microchipthailand/dspic33ck-nano/arduino/dsPIC33CK_Nano_Pinout.html

# dsPIC33CK Nano — Arduino-compatible Pinout

dsPIC33CK256MC005 · 100 MIPS DSC · 256 KB flash · 16 KB RAM · USB-C power · breadboard 0.9″ rows · Arduino core dspicnano:dspic33ck:dspic33ck_nano

## Pinout (top view, USB-C at the top)

USB 5V after diode5V1

GND2

RP65PWM4HRD1 D353

RP42PWM3HRB10 D154

RP43PWM3LRB11 D165

RP44PWM2HRB12 D176

RP45PWM2LRB13 D187

RP46PWM1HRB14 D198

RP47PWM1LRB15 D209

RP60BUTTONRC12 D3310

RP61LED_BUILTINRC13 D3411

RESETMCLR12

RP77RD13 D3813

RP48AN12RC0A13D2114

CMP1AOA1OUTAN0RA0A0D015

OA1IN-AN16RA1A1D116

OA1IN+AN9RA2A2D217

CMP1CDACOUT1AN3RA3A3D318

OA3OUTAN4RA4A4D419

RP49CMP1BOA3IN-AN13RC1A14D2220

RP50CMP2BOA3IN+AN14RC2A15D2321

RP54AN19RC6A17D2722

dsPIC33CK Nano top view

13V33.3 V out, 250 mA

2GND

3D32 RC11Serial RXRP59

4D31 RC10Serial TXRP58

5D26 RC5MOSIRP53

6D25 RC4SCKRP52

7D14A12RB9AN11SDARP41

8D13A11RB8AN10SCLRP40

9D12A10RB7AN2RP39

10D11 RB6PGC3RP38

11D10 RB5PGD3RP37

12D36 RD8RP72

13D30 RC9SSRP57

14D29 RC8MISORP56

15D9A9RB4AN17OA2IN+RP36

16D8A8RB3AN8~PWMOA2IN-RP35

17D7A7RB2AN1~PWMOA2OUTCMP1DCMP2DRP34

18D28A18RC7AN7RP55

19D37A19RD10AN18RP74

20D6A6RB1AN6~PWMRP33

21D5A5RB0AN5~PWMRP32

22D24A16RC3AN15CMP2ARP51

D0Arduino digital pin

A0analogRead() name

RA0chip port pin (silkscreen)

AN0ADC channel

~PWManalogWrite()

SerialUART1

SDAWire

SCKSPI

LEDon-board

PGD3ICSP

PWM1Hother chip function

RP46remappable (PPS)

3V3power

GNDground

Left header is J2, right header is J3, both numbered from the USB-C end (pin 1 = 5V / 3V3). The rows are 0.9″ (22.86 mm) apart, so the board straddles a standard breadboard. The AN channel and the A name are different numbers on this chip — use the A name in sketches.

## Arduino functions

Function | Signal | Pin | Port | Header
Serial (UART1) | TX | D31 | RC10 | J3-4
Serial (UART1) | RX | D32 | RC11 | J3-3
Wire (I2C1) | SDA | D14 | RB9 | J3-7
Wire (I2C1) | SCL | D13 | RB8 | J3-8
SPI (SPI1) | SCK | D25 | RC4 | J3-6
SPI (SPI1) | MOSI | D26 | RC5 | J3-5
SPI (SPI1) | MISO | D29 | RC8 | J3-14
SPI (SPI1) | SS | D30 | RC9 | J3-13
analogWrite() | PWM1 | D5 | RB0 | J3-21
analogWrite() | PWM2 | D6 | RB1 | J3-20
analogWrite() | PWM3 | D7 | RB2 | J3-17
analogWrite() | PWM4 | D8 | RB3 | J3-16
On-board | LED_BUILTIN (active low) | D34 | RC13 | J2-11
On-board | BUTTON_BUILTIN (LOW = pressed) | D33 | RC12 | J2-10
ICSP J4 | PGD3 | D10 | RB5 | J3-11
ICSP J4 | PGC3 | D11 | RB6 | J3-10

## Analog inputs (analogRead, 12-bit → 0..1023)

Name | Pin | Port | ADC | Header
A0 | D0 | RA0 | AN0 | J2-15
A1 | D1 | RA1 | AN16 | J2-16
A2 | D2 | RA2 | AN9 | J2-17
A3 | D3 | RA3 | AN3 | J2-18
A4 | D4 | RA4 | AN4 | J2-19
A5 | D5 | RB0 | AN5 | J3-21
A6 | D6 | RB1 | AN6 | J3-20
A7 | D7 | RB2 | AN1 | J3-17
A8 | D8 | RB3 | AN8 | J3-16
A9 | D9 | RB4 | AN17 | J3-15
A10 | D12 | RB7 | AN2 | J3-9
A11 | D13 | RB8 | AN10 | J3-8
A12 | D14 | RB9 | AN11 | J3-7
A13 | D21 | RC0 | AN12 | J2-14
A14 | D22 | RC1 | AN13 | J2-20
A15 | D23 | RC2 | AN14 | J2-21
A16 | D24 | RC3 | AN15 | J3-22
A17 | D27 | RC6 | AN19 | J2-22
A18 | D28 | RC7 | AN7 | J3-18
A19 | D37 | RD10 | AN18 | J3-19

## On-board hardware

MCU | dsPIC33CK256MC005-I/PT, TQFP-48, internal FRC + PLL (no crystal)
Clock (Tools > Clock) | 100 MIPS (FOSC 200 MHz, default) or 4 MIPS (FRC 8 MHz)
Power | USB-C 5 V → B5819W diode → MCP1703A 3.3 V LDO, 250 mA
USER LED (D3, yellow) | RC13 = LED_BUILTIN = D34, active low — use LED_ON/LED_OFF
PWR LED (D2, green) | hard-wired to 3V3
USER button (SW2) | RC12 = BUTTON_BUILTIN = D33, 10 k pull-up on board, LOW = pressed
RESET button (SW1) | MCLR (10 k pull-up, 470 Ω + 100 nF)

J4 ICSP (6-pin) | 1 MCLR · 2 3V3 · 3 GND · 4 PGD3 (RB5) · 5 PGC3 (RB6) · 6 n/c — PICkit 4/5, SNAP
J5 UART (4-pin) | 1 3V3 · 2 TX (RC10) · 3 RX (RC11) · 4 GND — 3.3 V USB-serial adapter
PWM | D5 D6 D7 D8 (SCCP1-4, ~490 Hz)
Interrupts | attachInterrupt() on every pin (change notification)
Board size | 31.4 × 74.5 mm, 2 × 22 pins, red PCB

3.3 V only. The I/O pins are not 5 V tolerant. The 5V pin is USB power after the diode (about 4.6 V) — an output for modules, never a signal level.

- tone() borrows timer SCCP4, which is the PWM of D8. Don't use analogWrite(8, …) while a tone plays.
- RB5/RB6 (D10/D11) are the ICSP lines. They are free I/O when no debugger is connected, but anything wired there can disturb programming.
- RB10–RB15, RD1 are the motor-control PWM pins of the chip (PWM1H..PWM4H); in Arduino they are ordinary digital I/O.
- PORTA (RA0–RA4) has no PPS, so no remappable peripheral can use it; it is the best place for analog inputs.

## Getting started

1. Install XC-DSC v4.00+ (compiler) and MPLAB X (for uploading with a PICkit/SNAP).
2. In File > Preferences > Additional boards manager URLs add https://raw.githubusercontent.com/microchipthailand/dspic33ck-nano/main/package_dspicnano_index.json, then Tools > Board > Boards Manager → search dsPIC33CK Nano → Install. The device packs are installed automatically. Alternative for core development: copy arduino/hardware into your sketchbook so you get <sketchbook>/hardware/dspicnano/dspic33ck/boards.txt (do not use both at once).
3. Tools > Board → dsPIC33CK Nano (dsPIC33CK256MC005). Tools > Debugger → the programmer you have on J4.
4. Power the board from USB-C, plug the PICkit into J4 (pin 1 = MCLR, square pad), and upload File > Examples > dsPIC33CK_Nano > Lab01_Blink.

### Optional: upload over the J5 serial port (no PICkit)

1. Once, with the PICkit: Tools > Burn Bootloader.
2. Connect a 3.3 V USB-serial adapter to J5 (adapter RX → J5-2, adapter TX → J5-3, GND → J5-4), pick its COM port.
3. Tools > Bootloader → Serial over J5 (UART 115200), then Upload as usual.
4. If the sketch running on the board doesn't use Serial, the upload can't reset it. Hold USER, press and release RESET, keep holding USER for about a second (the LED stays on), then upload.

Uploading with the PICkit erases the bootloader. Burn it again before going back to serial uploads.

## Lab examples (File > Examples > dsPIC33CK_Nano)

# | Sketch | What it does | Learns | Extra parts

01 | Lab01_Blink | Blink the USER LED | digitalWrite, delay | nothing
02 | Lab02_ButtonLED | Button toggles LED, debounced | digitalRead, millis | nothing
03 | Lab03_SerialHello | Serial Monitor print + commands | Serial | USB-serial adapter on J5
04 | Lab04_AnalogRead | Potentiometer to volts | analogRead | 10k pot on A0 (J2-15)
05 | Lab05_PWMFade | PWM LED fade / pot dimmer | analogWrite, map | LED + 330R on D5 (J3-21)
06 | Lab06_Interrupt | Count presses in an ISR | attachInterrupt, volatile | nothing
07 | Lab07_Tone | Play a melody | tone, noTone, arrays | piezo on D9 (J3-15)
08 | Lab08_I2CScanner | Find I2C devices | Wire | any 3.3 V I2C module
09 | Lab09_SPILoopback | SPI self-test | SPI | jumper J3-5 to J3-14
10 | Lab10_DataLogger | 3-channel CSV logger + alarm | all of the above | pot, LDR, buzzer

## All digital pins

Pin | Port | Analog | ADC | Header | Functions
D0 | RA0 | A0 | AN0 | J2-15 | OA1OUT, CMP1A
D1 | RA1 | A1 | AN16 | J2-16 | OA1IN-
D2 | RA2 | A2 | AN9 | J2-17 | OA1IN+
D3 | RA3 | A3 | AN3 | J2-18 | DACOUT1, CMP1C
D4 | RA4 | A4 | AN4 | J2-19 | OA3OUT
D5 | RB0 | A5 | AN5 | J3-21 | ~PWM, RP32
D6 | RB1 | A6 | AN6 | J3-20 | ~PWM, RP33
D7 | RB2 | A7 | AN1 | J3-17 | ~PWM, OA2OUT, CMP1D, CMP2D, RP34
D8 | RB3 | A8 | AN8 | J3-16 | ~PWM, OA2IN-, RP35
D9 | RB4 | A9 | AN17 | J3-15 | OA2IN+, RP36
D10 | RB5 | | | J3-11 | PGD3, RP37
D11 | RB6 | | | J3-10 | PGC3, RP38
D12 | RB7 | A10 | AN2 | J3-9 | RP39
D13 | RB8 | A11 | AN10 | J3-8 | SCL, RP40
D14 | RB9 | A12 | AN11 | J3-7 | SDA, RP41
D15 | RB10 | | | J2-4 | PWM3H, RP42
D16 | RB11 | | | J2-5 | PWM3L, RP43
D17 | RB12 | | | J2-6 | PWM2H, RP44
D18 | RB13 | | | J2-7 | PWM2L, RP45
D19 | RB14 | | | J2-8 | PWM1H, RP46
D20 | RB15 | | | J2-9 | PWM1L, RP47
D21 | RC0 | A13 | AN12 | J2-14 | RP48
D22 | RC1 | A14 | AN13 | J2-20 | OA3IN-, CMP1B, RP49
D23 | RC2 | A15 | AN14 | J2-21 | OA3IN+, CMP2B, RP50
D24 | RC3 | A16 | AN15 | J3-22 | CMP2A, RP51
D25 | RC4 | | | J3-6 | SCK, RP52
D26 | RC5 | | | J3-5 | MOSI, RP53
D27 | RC6 | A17 | AN19 | J2-22 | RP54
D28 | RC7 | A18 | AN7 | J3-18 | RP55
D29 | RC8 | | | J3-14 | MISO, RP56
D30 | RC9 | | | J3-13 | SS, RP57
D31 | RC10 | | | J3-4 | Serial TX, RP58
D32 | RC11 | | | J3-3 | Serial RX, RP59
D33 | RC12 | | | J2-10 | BUTTON, RP60
D34 | RC13 | | | J2-11 | LED_BUILTIN, RP61
D35 | RD1 | | | J2-3 | PWM4H, RP65
D36 | RD8 | | | J3-12 | RP72
D37 | RD10 | A19 | AN18 | J3-19 | RP74
D38 | RD13 | | | J2-13 | RP77

Generated by tools/gen_pinout_html.py from variants/dspic33ck_nano/variant.c, pins_arduino.h and the PCB netlist (design.py). The script checks that the three agree before it writes this page.

Arduino-compatible core. Not affiliated with or endorsed by Arduino SA. “Arduino” is a trademark of Arduino SA. Microchip, dsPIC, MPLAB and Curiosity are trademarks of Microchip Technology Inc. See NOTICE.md.
