microchipthailand/dspic33ck-nano/pcb/kicad/tracks_bot.png

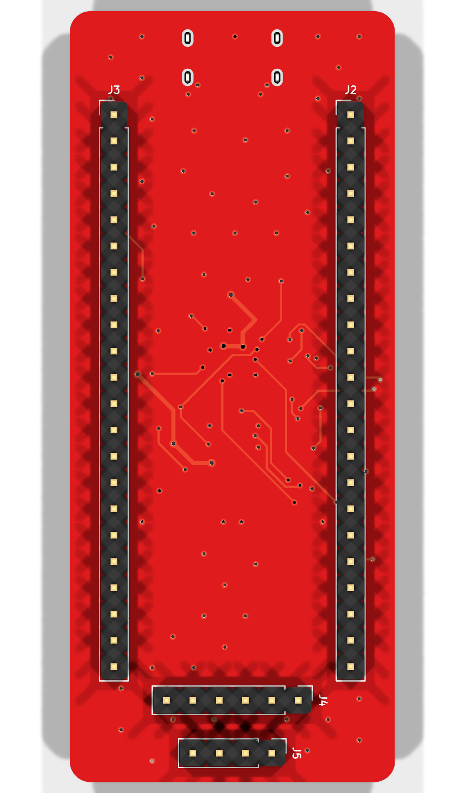
pcb/kicad/tracks_bot.png
