microchipthailand/dspic33ck-nano/pcb/kicad/tracks_top.png

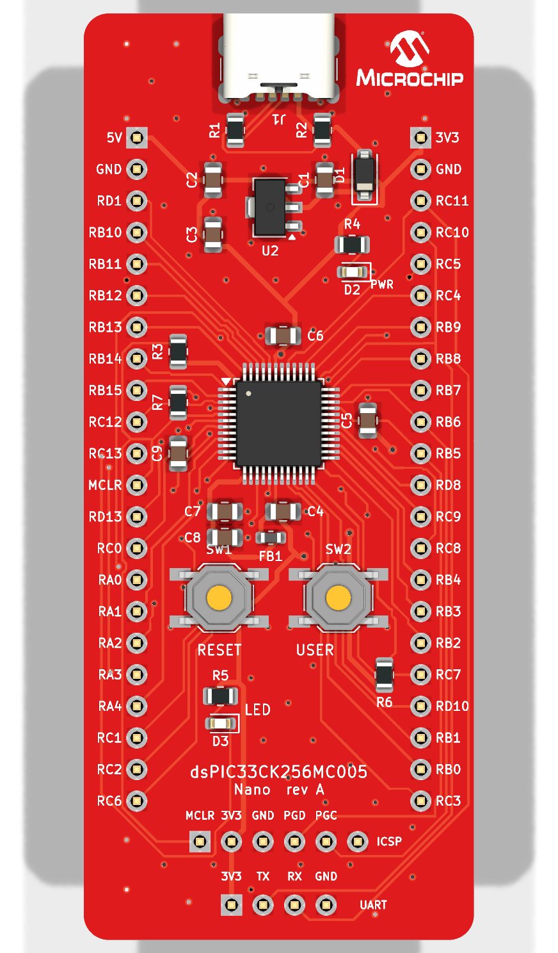
pcb/kicad/tracks_top.png
