microchipthailand/dspic33ck-nano/pcb/fabrication/assembly/dspic33ck_nano-bom.csv

Reference | Value | Footprint | QUANTITY | MPN
C1,C2,C8 | 1uF | Capacitor_SMD:C_0805_2012Metric | 3 | 0805 1uF 16V X7R
C3 | 10uF | Capacitor_SMD:C_0805_2012Metric | 1 | 0805 10uF 10V X5R
C4,C5,C6,C7,C9 | 100nF | Capacitor_SMD:C_0805_2012Metric | 5 | 0805 100nF 16V X7R
D1 | B5819W | Diode_SMD:D_SOD-123 | 1 | B5819W
D2 | PWR green | LED_SMD:LED_0603_1608Metric | 1 | 0603 green LED
D3 | USER yellow | LED_SMD:LED_0603_1608Metric | 1 | 0603 yellow LED
FB1 | 600R@100MHz | Inductor_SMD:L_0603_1608Metric | 1 | BLM18AG601SN1D
J1 | USB-C power | Connector_USB:USB_C_Receptacle_GCT_USB4125-xx-x-0190_6P_TopMnt_Horizontal | 1 | GCT USB4125-GF-A
J2 | LEFT | Connector_PinHeader_2.54mm:PinHeader_1x22_P2.54mm_Vertical | 1 | 1x22 2.54mm header
J3 | RIGHT | Connector_PinHeader_2.54mm:PinHeader_1x22_P2.54mm_Vertical | 1 | 1x22 2.54mm header
J4 | ICSP | Connector_PinHeader_2.54mm:PinHeader_1x06_P2.54mm_Vertical | 1 | 1x6 2.54mm header (PICkit)
J5 | UART | Connector_PinHeader_2.54mm:PinHeader_1x04_P2.54mm_Vertical | 1 | 1x4 2.54mm header (UART)
R1,R2 | 5.1k | Resistor_SMD:R_0805_2012Metric | 2 | 0805 5.1k 1%
R3,R6 | 10k | Resistor_SMD:R_0805_2012Metric | 2 | 0805 10k 1%
R4,R5 | 1k | Resistor_SMD:R_0805_2012Metric | 2 | 0805 1k 1%
R7 | 470 | Resistor_SMD:R_0805_2012Metric | 1 | 0805 470R 1%
SW1 | RESET | Button_Switch_SMD:SW_SPST_TL3342 | 1 | E-Switch TL3342 series (4.2x3.2mm SMD tact)
SW2 | USER | Button_Switch_SMD:SW_SPST_TL3342 | 1 | E-Switch TL3342 series (4.2x3.2mm SMD tact)
U1 | dsPIC33CK256MC005-I/PT | Package_QFP:TQFP-48_7x7mm_P0.5mm | 1 | dsPIC33CK256MC005-I/PT
U2 | MCP1703A-3302E/MB | Package_TO_SOT_SMD:SOT-89-3 | 1 | MCP1703AT-3302E/MB
