microchipthailand/dspic33ck-nano/pcb/kicad/board_guide.html

# dsPIC33CK256MC005 Nano Board

A breadboard-friendly development board for the Microchip dsPIC33CK256MC005 digital signal controller, powered from USB-C.

Rev A 31.4 × 74.5 mm 2 layers · 1.6 mm FR-4 Red mask · rounded corners USB-C 5 V → 3.3 V KiCad 10

## 1. Overview

This board breaks out every I/O pin of the dsPIC33CK256MC005-I/PT (48-pin TQFP, 7 × 7 mm, 0.5 mm pitch) to two 22-pin 2.54 mm headers. Its form factor follows Microchip's Curiosity Nano boards: a narrow stick that plugs straight into a solderless breadboard. It contains only what the MCU needs to run (power, decoupling, reset and programming), plus a UART header, two LEDs and two buttons.

### Key features

- dsPIC33CK256MC005: 100 MIPS, 256 KB flash, 24 KB RAM, motor-control PWM, 3 op-amps, 12-bit ADC
- USB-C power input (power only, no USB data)
- MCP1703A-3302 LDO: 3.3 V, 250 mA
- Ferrite-filtered analog supply (AVDD)
- 6-pin ICSP header for PICkit 4/5, MPLAB Snap or ICD
- 4-pin UART header (3V3 / TX / RX / GND)
- RESET and USER buttons, power and user LEDs
- All 0805 resistors and capacitors, easy to hand-solder

### Electrical summary

Input | 5 V via USB-C (or 5V header pin)
Logic level | 3.3 V. I/O pins are not 5 V tolerant unless the datasheet marks them so
3.3 V budget | 250 mA from the LDO, minus about 50–70 mA for the MCU at full speed
Clock | Internal FRC 8 MHz + PLL (no crystal fitted). RB0/RB1 are free for an external oscillator
Reverse-feed protection | B5819W Schottky between VBUS and the 5 V rail

## 2. Board views

3D render of the top side

Top side: components, pin labels and Microchip logo

3D render of the bottom side

Bottom side: pin headers point down into the breadboard (mirrored view)

Top copper routing

Top copper with the pours hidden: almost all signal routing is here

Bottom copper routing

Bottom copper with the pours hidden: only short crossings, so the GND plane stays almost unbroken

Header orientation. The pin headers mount on the bottom side with the pins pointing down, and the pin names are printed on the top side, so they can be read while the board is in a breadboard. Solder the headers from the top.

## 3. Block diagram

USB-C (J1) ──VBUS──► D1 B5819W ──+5V──► U2 MCP1703A-3302 ──+3V3──┬──► U1 VDD (pins 18, 32, 43) + 100 nF each │ CC1/CC2: 5.1 kΩ to GND (R1, R2) │ 1 µF 1 µF + 10 µF │ │ ▼ ├──► FB1 ferrite ──+3V3A──► U1 AVDD (pin 13) └─ 5V header pin (J2-1) ◄──────────── +5V rail │ 1 µF + 100 nF ├──► J3-1, ICSP J4-2, UART J5-1 └──► PWR LED D2 (via R4 1 kΩ) ┌──────────────────────── U1 dsPIC33CK256MC005-I/PT ────────────────────────┐ RESET ─► │ MCLR (5) ◄─ R3 10 kΩ pull-up ◄─ R7 470 Ω ◄─ C9 100 nF + SW1 │ ICSP J4 ─►│ PGD3/RB5 (33), PGC3/RB6 (34) │ UART J5 ◄►│ RC10/RP58 (40) = TX RC11/RP59 (41) = RX │ LED D3 ◄─│ RC13 (4), active low USER SW2 ─► RC12 (3), active low, R6 pull-up │ Headers ◄►│ all remaining I/O → J2 (left) / J3 (right) │ └────────────────────────────────────────────────────────────────────────────┘

## 4. Power supply

### USB-C input

J1 is a 6-pin power-only USB-C receptacle (GCT USB4125). R1/R2 (5.1 kΩ) pull CC1 and CC2 to ground, which tells the host or charger that this is a "sink" device. Without them, a USB-C charger supplies no power. The board asks for default USB power (500 mA from a USB 2.0 port, up to 1.5–3 A from a charger). It only needs a fraction of that.

### Reverse-feed protection

D1 (B5819W Schottky) sits between VBUS and the board's 5 V rail. The 5V header pin is on the protected side, so 5 V applied to that pin cannot flow back into a connected PC. The diode drops about 0.3–0.4 V, so the 5 V rail is about 4.6 V. That leaves plenty of headroom for the 3.3 V LDO.

### 3.3 V regulator

Part | MCP1703A-3302E/MB (SOT-89-3)
Pinout (SOT-89) | 1 = GND, 2 + tab = VIN, 3 = VOUT (from Microchip datasheet DS20005122, Table 3-1)
Input capacitor | C1 1 µF X7R
Output capacitors | C2 1 µF + C3 10 µF. The datasheet requires ≥ 1 µF and allows up to 22 µF ceramic. About 11 µF plus the 3×100 nF decoupling stays inside that range
Max output | 250 mA
Dissipation | (4.6 V − 3.3 V) × 100 mA ≈ 0.13 W, well within SOT-89 limits

### Analog supply

The MCU's AVDD (pin 13) powers the ADC, op-amps, comparators and DAC. It is fed through FB1, a 600 Ω at 100 MHz ferrite bead, and decoupled with C7 100 nF + C8 1 µF, which keeps digital switching noise out of analog measurements. AVSS (pin 14) goes straight to the ground plane.

Powering from the headers: you can power the board from 5 V on J2-1 (5V), or from 3.3 V on J3-1 (3V3), which bypasses the LDO. Never feed 3.3 V into the 3V3 pin while USB-C is also connected. The UART header's 3V3 pin is the same rail, so connect it only if the USB-serial adapter is meant to power the board.

## 5. MCU support circuitry

Function | Parts | Notes
VDD decoupling | C4 (pin 18), C5 (pin 32), C6 (pin 43): 100 nF | One per VDD pin, each placed right at its pin, with its own GND via to the bottom plane
VCAP | none | The dsPIC33CK family has no VCAP pin, so no core-regulator capacitor is needed
Reset (MCLR, pin 5) | R3 10 kΩ pull-up, R7 470 Ω, C9 100 nF, SW1 | R7 isolates C9 and SW1 from the pin, so the programmer can still drive the VPP/MCLR edge cleanly (Microchip's recommended circuit)
Clock | none fitted | Internal FRC + PLL gives the full 100 MIPS. For a crystal, use OSCI/RB0 (pin 21) and OSCO/RB1 (pin 22) from the headers

## 6. Header pinout

The pins are numbered from the USB-C end. The left header is J2 and the right header is J3 (as seen from the top). The rows are 0.9" (22.86 mm) apart. The order follows the chip's pins around the package, which keeps the traces short and untangled.

Pin | J2 (left) | MCU pin | Main functions
1 | 5V | — | 5 V rail (after D1)
2 | GND | — | Ground
3 | RD1 | 44 | RP65 · PWM4H · RD1
4 | RB10 | 45 | TMS · RP42 · PWM3H · RB10
5 | RB11 | 46 | TCK · RP43 · PWM3L · RB11
6 | RB12 | 47 | TDI · RP44 · PWM2H · RB12
7 | RB13 | 48 | RP45 · PWM2L · RB13
8 | RB14 | 1 | RP46 · PWM1H · RB14
9 | RB15 | 2 | RP47 · PWM1L · RB15
10 | RC12 | 3 | RP60 · RC12 — USER button
11 | RC13 | 4 | RP61 · RC13 — USER LED
12 | MCLR | 5 | MCLR — Reset / ICSP VPP
13 | RD13 | 6 | ANN0 · RP77 · RD13
14 | RC0 | 7 | AN12 · RP48 · RC0
15 | RA0 | 8 | OA1OUT · AN0 · CMP1A · IBIAS0 · RA0
16 | RA1 | 9 | OA1IN- · AN16 · RA1
17 | RA2 | 10 | OA1IN+ · AN9 · RA2
18 | RA3 | 11 | DACOUT1 · AN3 · CMP1C · RA3
19 | RA4 | 12 | OA3OUT · AN4 · IBIAS3 · RA4
20 | RC1 | 15 | OA3IN- · AN13 · CMP1B · ISRC0 · RP49 · RC1
21 | RC2 | 16 | OA3IN+ · AN14 · CMP2B · ISRC1 · RP50 · RC2
22 | RC6 | 17 | AN19 · IBIAS1 · RP54 · RC6

Pin | J3 (right) | MCU pin | Main functions
1 | 3V3 | — | 3.3 V rail (LDO output)
2 | GND | — | Ground
3 | RC11 | 41 | RP59 · RC11 — UART RX (J5-3)
4 | RC10 | 40 | RP58 · RC10 — UART TX (J5-2)
5 | RC5 | 39 | RP53 · RC5
6 | RC4 | 38 | RP52 · RC4
7 | RB9 | 37 | PGC1 · AN11 · RP41 · SDA1 · RB9
8 | RB8 | 36 | PGD1 · AN10 · RP40 · SCL1 · RB8
9 | RB7 | 35 | TDO · AN2 · RP39 · RB7
10 | RB6 | 34 | PGC3 · RP38 · RB6 — ICSP PGC
11 | RB5 | 33 | PGD3 · RP37 · RB5 — ICSP PGD
12 | RD8 | 30 | RP72 · SDO2 · PCI19 · RD8
13 | RC9 | 29 | RP57 · ASCL1 · SDI2 · RC9
14 | RC8 | 28 | RP56 · ASDA1 · SCK2 · RC8
15 | RB4 | 27 | PGC2 · OA2IN+ · AN17 · RP36 · RB4
16 | RB3 | 26 | PGD2 · OA2IN- · AN8 · RP35 · RB3
17 | RB2 | 25 | OA2OUT · AN1 · CMP1D · CMP2D · RP34 · INT0 · RB2
18 | RC7 | 24 | AN7 · ISRC2 · RP55 · RC7
19 | RD10 | 23 | AN18 · ISRC3 · RP74 · RD10
20 | RB1 | 22 | OSCO · CLKO · AN6 · RP33 · RB1
21 | RB0 | 21 | OSCI · CLKI · AN5 · RP32 · RB0
22 | RC3 | 20 | AN15 · CMP2A · IBIAS2 · RP51 · RC3

PWR power GND ground PROG used by on-board circuitry or programming I/O general-purpose

Pins marked PROG are shared with on-board functions. RB5/RB6 are the programming pins (PGD3/PGC3), RC10/RC11 the UART, RC12 the USER button (10 kΩ pull-up) and RC13 the USER LED. You can still use them from the header, but take the on-board load into account.

### Useful peripheral pins

Peripheral | Pins
Motor-control PWM | PWM1H/L = RB14/RB15 · PWM2H/L = RB12/RB13 · PWM3H/L = RB10/RB11 · PWM4H = RD1
Op-amp 1 (current sense) | OA1OUT = RA0 · OA1IN− = RA1 · OA1IN+ = RA2
Op-amp 2 | OA2OUT = RB2 · OA2IN− = RB3 · OA2IN+ = RB4
Op-amp 3 | OA3OUT = RA4 · OA3IN− = RC1 · OA3IN+ = RC2
DAC output | DACOUT1 = RA3
I²C1 (fixed) | SCL1 = RB8 · SDA1 = RB9 (alternate ASCL1/ASDA1 = RC9/RC8)
SPI2 (fixed) | SCK2 = RC8 · SDI2 = RC9 · SDO2 = RD8
Remappable (PPS) | Every RPxx pin can carry UART, SPI1, QEI, SENT, timers, input capture and similar peripherals

## 7. Programming and debugging (J4, ICSP)

J4 is a 6-pin 2.54 mm header in Microchip's standard ICSP order. Pin 1 is marked with a square pad and the MCLR label.

Pin | Signal | Connects to
1 | MCLR / VPP | U1 pin 5
2 | VDD (3.3 V) | +3V3 rail (the programmer senses the target voltage)
3 | GND | Ground
4 | PGD | PGD3 / RB5, U1 pin 33
5 | PGC | PGC3 / RB6, U1 pin 34
6 | — | Not connected (LVP/aux on PICkit)

PGD3/PGC3 were chosen because the other two programming pairs share pins with useful peripherals: PGx1 = RB8/RB9 carries I²C1, and PGx2 = RB3/RB4 carries op-amp 2's inputs. Your firmware must select PGx3 in its configuration bits (see the firmware section). Otherwise debugging won't connect.

Power the board from USB-C while programming. A PICkit can also power the target from pin 2, but don't do both at once.

## 8. UART header (J5)

Pin | Signal | MCU | Connect to USB-serial adapter
1 | 3V3 | +3V3 rail | VCC, only if the adapter should power the board and USB-C is unplugged
2 | TX (board output) | RC10 / RP58 (pin 40) | adapter RX
3 | RX (board input) | RC11 / RP59 (pin 41) | adapter TX
4 | GND | Ground | GND (always)

Use a 3.3 V adapter (FTDI TTL-232R-3V3, CP2102 or CH340 set to 3.3 V, MCP2221A). A 5 V adapter can damage the RX pin. UART1 is routed to these pins with peripheral pin select (PPS) in firmware; see below.

## 9. LEDs and buttons

Ref | Function | Connection | Logic
D2 (green) | Power LED | +3V3 → R4 1 kΩ → LED → GND | On whenever 3.3 V is present (about 1.3 mA)
D3 (yellow) | User LED | +3V3 → R5 1 kΩ → LED → RC13 | Active low: drive RC13 = 0 to light it
SW1 | RESET | MCLR via R7/C9 | Press to reset
SW2 | USER | RC12 → GND, R6 10 kΩ pull-up | Active low: reads 0 when pressed

## 10. Firmware starter (MPLAB X + XC-DSC/XC16)

A minimal program for this board: 100 MIPS from the internal oscillator, UART1 on J5 at 115200 baud, and the user LED following the button.

#include <xc.h>

// ---- configuration bits ----
#pragma config FNOSC = FRC          // start on FRC, switch to PLL in code
#pragma config FCKSM = CSECMD       // clock switching enabled
#pragma config ICS   = PGD3         // debugger on PGC3/PGD3 (J4) -- required!
#pragma config JTAGEN = OFF
#pragma config FWDTEN = ON_SW       // watchdog under software control

#define FCY 100000000UL             // 100 MIPS

static void clock_init(void)
{
    // FRC 8 MHz: FPLLO = 8 MHz * M / (N1 * N2 * N3) = 8 * 150 / (1 * 3 * 1) = 400 MHz; FCY = FPLLO/4 = 100 MHz
    CLKDIVbits.PLLPRE = 1;
    PLLFBDbits.PLLFBDIV = 150;
    PLLDIVbits.POST1DIV = 3;
    PLLDIVbits.POST2DIV = 1;
    __builtin_write_OSCCONH(0x01);  // new oscillator: FRC + PLL
    __builtin_write_OSCCONL(OSCCON | 0x01);
    while (OSCCONbits.OSWEN);       // wait for switch
    while (!OSCCONbits.LOCK);       // wait for PLL lock
}

static void pins_init(void)
{
    __builtin_write_RPCON(0x0000);  // unlock PPS
    _RP58R = 1;                     // RC10/RP58 -> U1TX   (J5 pin 2)
    _U1RXR = 59;                    // U1RX <- RC11/RP59    (J5 pin 3)
    __builtin_write_RPCON(0x0800);  // lock PPS

    _TRISC10 = 0;  _TRISC11 = 1;  _CNPUC11 = 1;   // UART: TX out, RX in with pull-up
    _TRISC13 = 0;  _LATC13 = 1;                   // user LED off (active low)
    _TRISC12 = 1;                                 // user button input (external pull-up)
}

static void uart1_init(unsigned long baud)
{
    U1MODEbits.BRGH = 0;                          // standard (16x) baud mode
    U1BRG = (FCY / (16UL * baud)) - 1;            // assumes UART clock = FCY (default); see note below
    U1MODEbits.UTXEN = 1;
    U1MODEbits.URXEN = 1;
    U1MODEbits.UARTEN = 1;
}

static void uart1_putc(char c) { while (U1STAHbits.UTXBF); U1TXREG = c; }
static void uart1_puts(const char *s) { while (*s) uart1_putc(*s++); }

int main(void)
{
    clock_init();
    pins_init();
    uart1_init(115200);
    uart1_puts("dsPIC33CK Nano ready\r\n");

    while (1) {
        _LATC13 = _RC12;            // LED on while USER button pressed (both active low)
    }
}

Check these against the dsPIC33CK256MC506 family datasheet before relying on them. The register and bit names (_RP58R, _U1RXR, _TRISC10, _CNPUC11, RPINR18/RPOR13) were confirmed in the device header p33CK256MC005.h from the installed device pack. The rest are written from memory and need checking:

- the PPS output code (U1TX = 1)
- the __builtin_write_RPCON unlock/lock values
- whether RC10/RC11 need ANSEL turned off
- the PLL divider values
- the UART baud formula, which depends on the UART clock source (U1MODEH.BCLKSEL)

Alternatively, use MCC (MPLAB Code Configurator), which generates verified setup code for the clock, PPS and UART.

## 11. PCB design

Item | Value
Size | 31.4 × 74.5 mm (header rows 0.9" apart, with a 3 mm label strip outside each row)
Board outline | Rectangle with 2.0 mm radius rounded corners (all four)
Stack-up | 2 layers, 1.6 mm FR-4, 1 oz copper
Finish | Red solder mask (both sides), white silkscreen, HASL lead-free
Logo | Microchip logo on top silkscreen, right of the USB-C connector (about 8.6 × 4.5 mm)
Top layer (F.Cu) | All components and most signal routing (about 89% of track length), plus a GND pour
Bottom layer (B.Cu) | Solid GND plane with only short signal crossings; pin headers are mounted on this side
Signal tracks | 0.20 mm width, 0.20 mm clearance
Power tracks (VBUS, +5V, +3V3, +3V3A, GND) | 0.40 mm width, 0.15 mm clearance
Vias | 0.6 mm / 0.3 mm drill (signal), 0.8 mm / 0.4 mm drill (power)
Copper to board edge | 0.30 mm
Fabrication class | Within JLCPCB / PCBWay standard 2-layer capability (no extra-cost options)

### Grounding approach

- Every GND pad has its own short trace and via to the bottom plane. That includes all four MCU ground pins (14, 19, 31, 42), whose vias sit under the chip body.
- The router was set to make bottom-layer traces 8× more costly than top-layer ones, so the plane stays almost unbroken under the MCU.
- Stitching vias tie the top-side GND pour to the bottom plane across the whole board, and pour fragments that don't reach a GND pad are removed.
- A connectivity check confirmed that all 135 GND items (pads, tracks, vias and pour pieces) form one single connected net.

### Verification results

Schematic ERC: 0 errors, 0 warnings.
Netlist check: 156 of 156 pins match the design specification.
PCB DRC: 0 errors, 0 unconnected items, with KiCad's schematic-parity check on. The only remaining note is ICSP J4 pin 6, which is unconnected on purpose.
GND connectivity: a single connected group across both layers.

## 12. Bill of materials

Ref | Qty | Value | Package | Description / part
C1,C2,C8 | 3 | 1uF | C_0805 (2012 metric) | 0805 1uF 16V X7R
C3 | 1 | 10uF | C_0805 (2012 metric) | 0805 10uF 10V X5R
C4-C7,C9 | 5 | 100nF | C_0805 (2012 metric) | 0805 100nF 16V X7R
D1 | 1 | B5819W | D_SOD-123 | B5819W
D2 | 1 | PWR green | LED_0603 (1608 metric) | 0603 green LED
D3 | 1 | USER yellow | LED_0603 (1608 metric) | 0603 yellow LED
FB1 | 1 | 600R@100MHz | L_0603 (1608 metric) | BLM18AG601SN1D
J1 | 1 | USB-C power | USB-C 6P horizontal | GCT USB4125-GF-A
J2 | 1 | LEFT | Header 1x22 2.54 mm | 1x22 2.54mm header
J3 | 1 | RIGHT | Header 1x22 2.54 mm | 1x22 2.54mm header
J4 | 1 | ICSP | Header 1x06 2.54 mm | 1x6 2.54mm header (PICkit)
J5 | 1 | UART | Header 1x04 2.54 mm | 1x4 2.54mm header (UART)
R1,R2 | 2 | 5.1k | R_0805 (2012 metric) | 0805 5.1k 1%
R3,R6 | 2 | 10k | R_0805 (2012 metric) | 0805 10k 1%
R4,R5 | 2 | 1k | R_0805 (2012 metric) | 0805 1k 1%
R7 | 1 | 470 | R_0805 (2012 metric) | 0805 470R 1%
SW1 | 1 | RESET | SW_SPST_TL3342 | E-Switch TL3342 series (4.2x3.2mm SMD tact)
SW2 | 1 | USER | SW_SPST_TL3342 | E-Switch TL3342 series (4.2x3.2mm SMD tact)
U1 | 1 | dsPIC33CK256MC005-I/PT | TQFP-48_7x7mm_P0.5mm | dsPIC33CK256MC005-I/PT
U2 | 1 | MCP1703A-3302E/MB | SOT-89-3 | MCP1703AT-3302E/MB

Several entries in the "part" column are generic descriptions, such as "0805 100nF 16V X7R". Choose a specific manufacturer part (for example from JLCPCB's basic parts library) before ordering assembly. For the LEDs, check the cathode mark: KiCad pin 1 = K (cathode).

## 13. Assembly notes

1. Order of soldering: start with U1 (TQFP-48), then U2, the USB-C connector J1, the passives, the LEDs and the buttons. Fit the pin headers last.
2. TQFP-48: tack two opposite corner pins, check the alignment on all four sides, then drag-solder with plenty of flux and clear bridges with wick. Pin 1 is marked by the triangle on the silkscreen.
3. LED polarity: the cathode goes to the pad marked on the silkscreen. D2's cathode goes to GND; D3's cathode goes to RC13.
4. D1 polarity: the cathode band faces the LDO (+5V side).
5. Pin headers: insert them from the bottom with the long pins pointing down, and solder from the top. To keep them straight, push the headers into a breadboard first, lay the board on top and then solder.
6. Clean the flux off, especially around the TQFP and MCLR network. Leftover flux can leak current on high-impedance nodes.

## 14. Bring-up checklist

1. Before applying power: check for shorts with a meter. 5V to GND, 3V3 to GND and 3V3A to GND should each read high resistance, not 0 Ω.
2. Plug in USB-C: the green PWR LED should light up. Measure the 3V3 pin: 3.25–3.35 V. Measure the 5V pin: about 4.6 V.
3. Measure AVDD at C8: it should equal 3V3.
4. Measure MCLR (J4-1): it should be at 3.3 V, and drop to 0 V while RESET is held.
5. Connect a PICkit to J4 (pin 1 = MCLR). In MPLAB X, choose Read Device ID; it should identify the dsPIC33CK256MC005.
6. Program the starter firmware. Open a terminal at 115200 8N1 on the UART adapter and look for "dsPIC33CK Nano ready". Press USER and the yellow LED should light.

## 15. Project files

File | Contents
dspic33ck_nano.kicad_pro | KiCad project (open this). Contains the design rules and net classes
dspic33ck_nano.kicad_sch | Schematic
dspic33ck_nano.kicad_pcb | Routed PCB
Board.kicad_sym | Project symbols: the dsPIC33CK256MC005 (pinout from Microchip's device file) and the MCP1703A in SOT-89
schematic.pdf · bom.csv | Exports
pcb/scripts/ | Generators: design.py (parts and nets) and build.sh, plus the routing scripts

Generated 2026-11-11 · dsPIC33CK256MC005 Nano board Rev A · KiCad 10.0.7 · routed with Freerouting 2.5.0.
The MCU pinout comes from Microchip's DSPIC33CK256MC005.PIC device file (dsPIC33CK-MC_DFP 1.10.386); the regulator data from MCP1703A datasheet DS20005122.
