microchipthailand/dspic33ck-nano/pcb/kicad/schematic.pdf

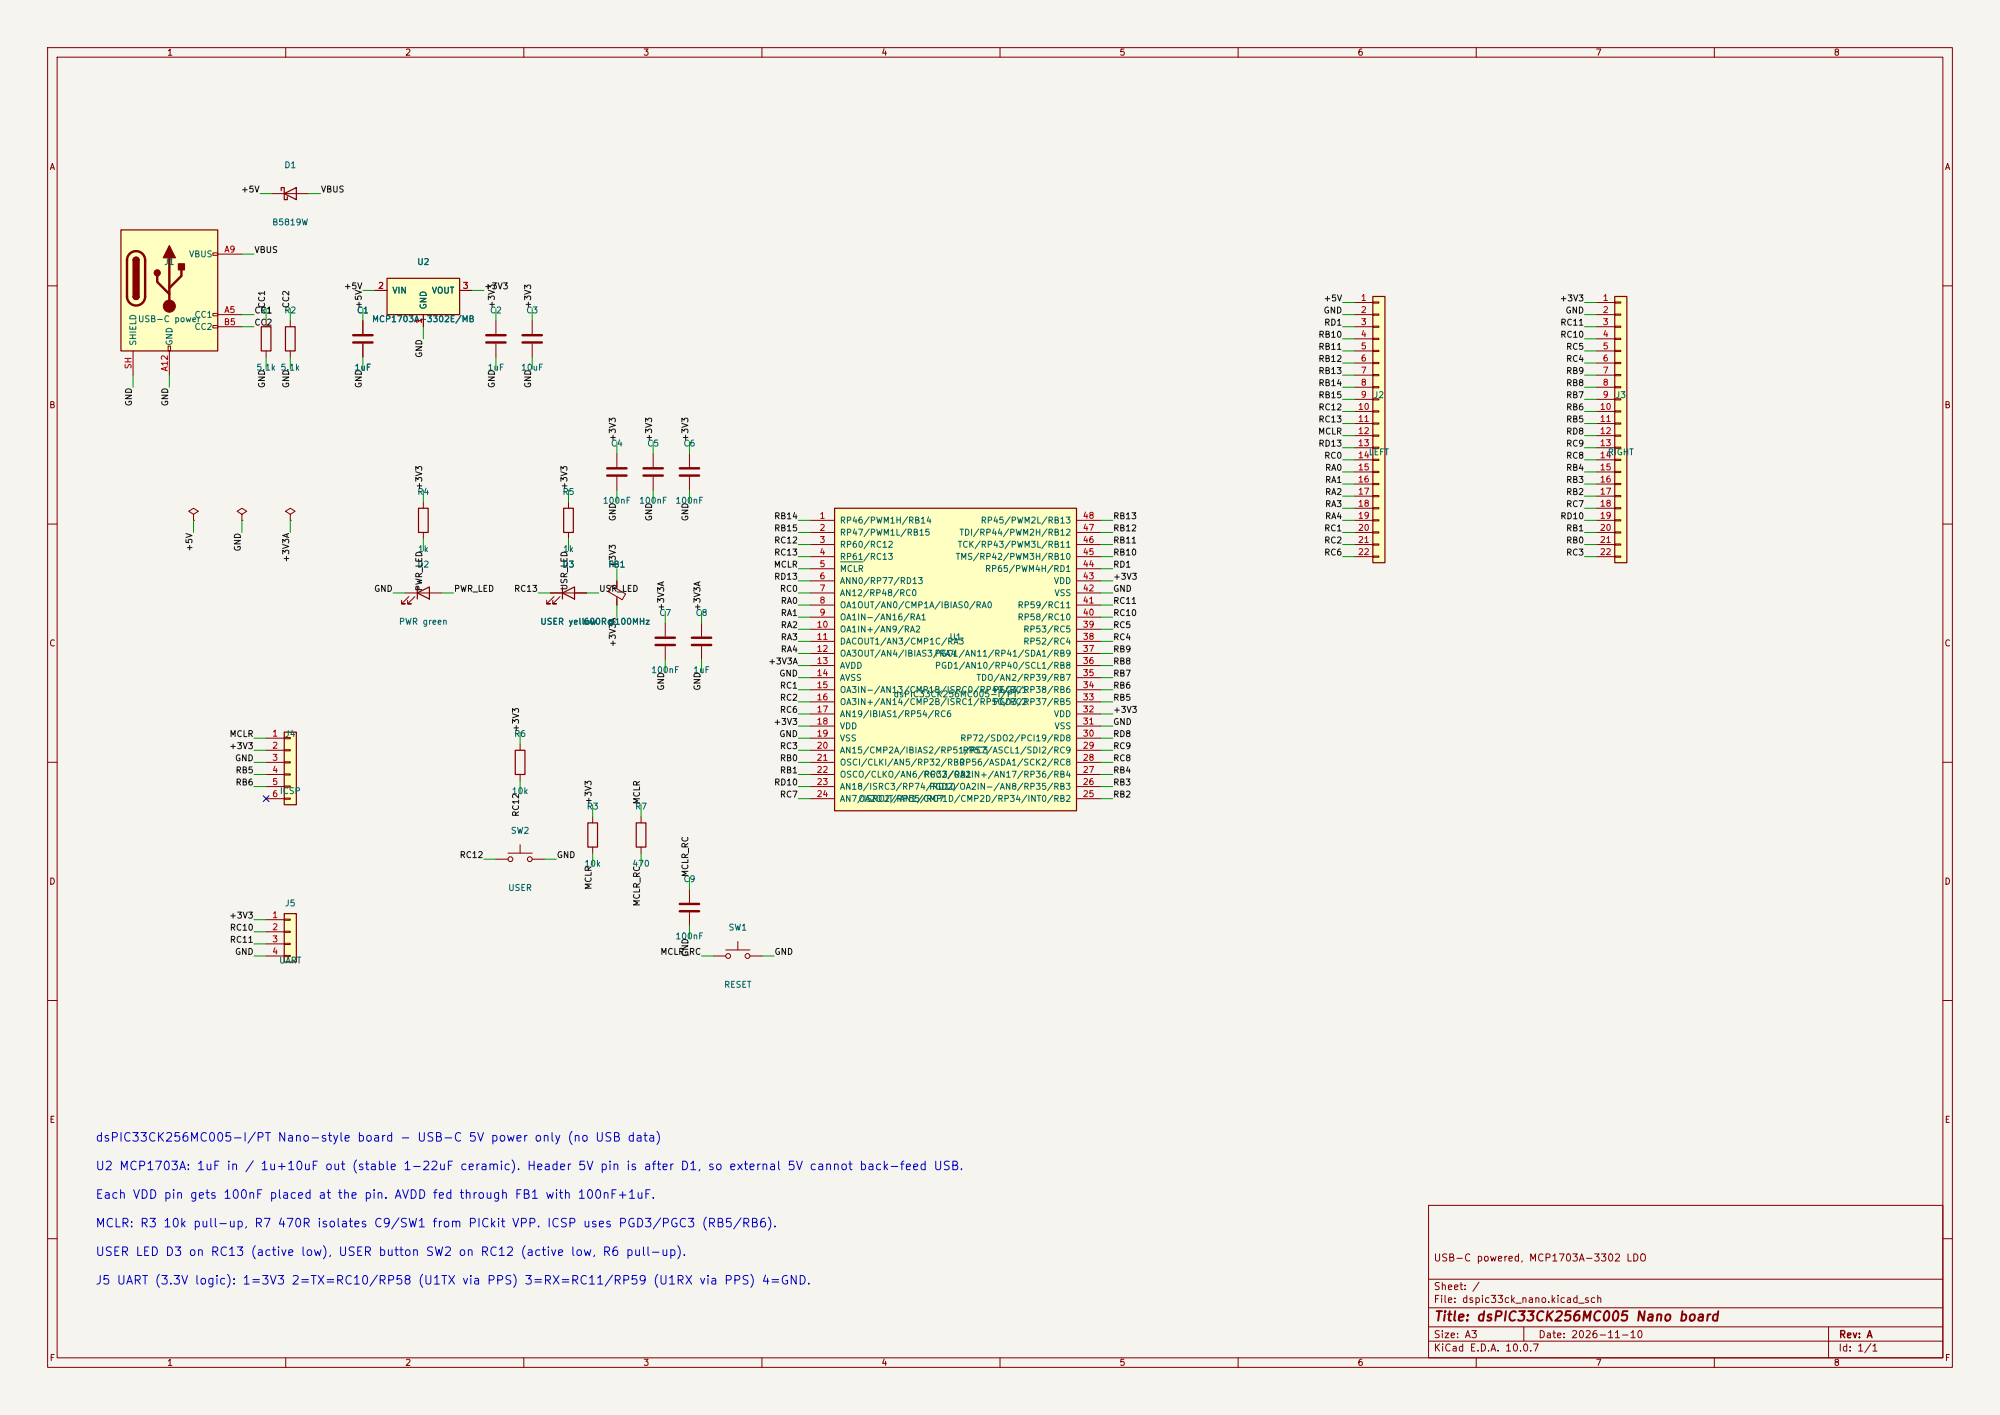
[picture p6: page 1]

dsPIC33CK256MC005-I/PT Nano-style board - USB-C 5V power only (no USB data)

U2 MCP1703A: 1uF in / 1u+10uF out (stable 1-22uF ceramic). Header 5V pin is after D1, so external 5V cannot back-feed USB.

Each VDD pin gets 100nF placed at the pin. AVDD fed through FB1 with 100nF+1uF.

MCLR: R3 10k pull-up, R7 470R isolates C9/SW1 from PICkit VPP. ICSP uses PGD3/PGC3 (RB5/RB6).

USER LED D3 on RC13 (active low), USER button SW2 on RC12 (active low, R6 pull-up).

J5 UART (3.3V logic): 1=3V3 2=TX=RC10/RP58 (U1TX via PPS) 3=RX=RC11/RP59 (U1RX via PPS) 4=GND.

Size: A3 | Rev: A | F Date: 2026-11-10
KiCad E.D.A. 10.0.7 | Id: 1/1
