microchipthailand/dspic33ck-nano/pcb/fabrication/docs/dspic33ck_nano-bottom.pdf

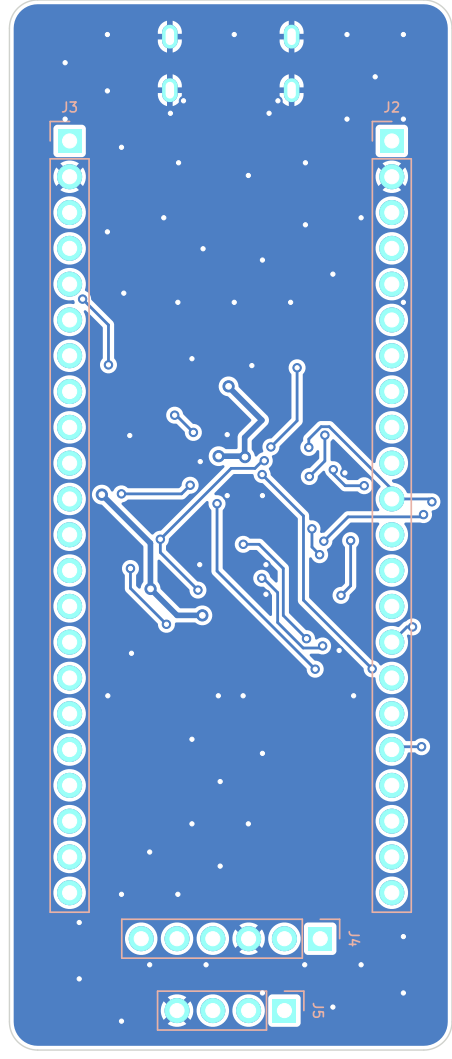
[picture p7: page 1]
