microchipthailand/dspic33ck-nano/pcb/fabrication/docs/dspic33ck_nano-top.pdf

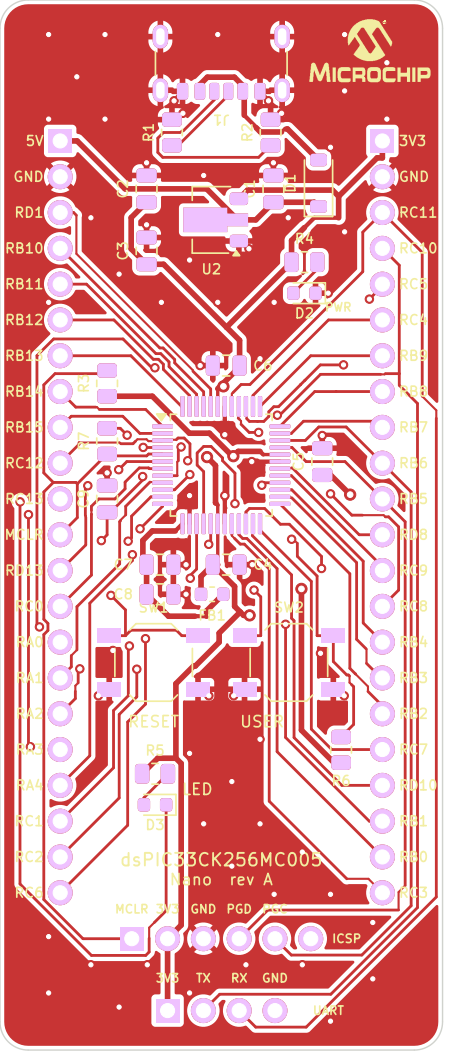
[picture p8: page 1]
