microchipthailand/dspic33ck-nano/pcb/kicad/dspic33ck_nano.kicad_pcb

## KiCad design pcb/kicad/dspic33ck_nano.kicad_pcb (2026-11-12)

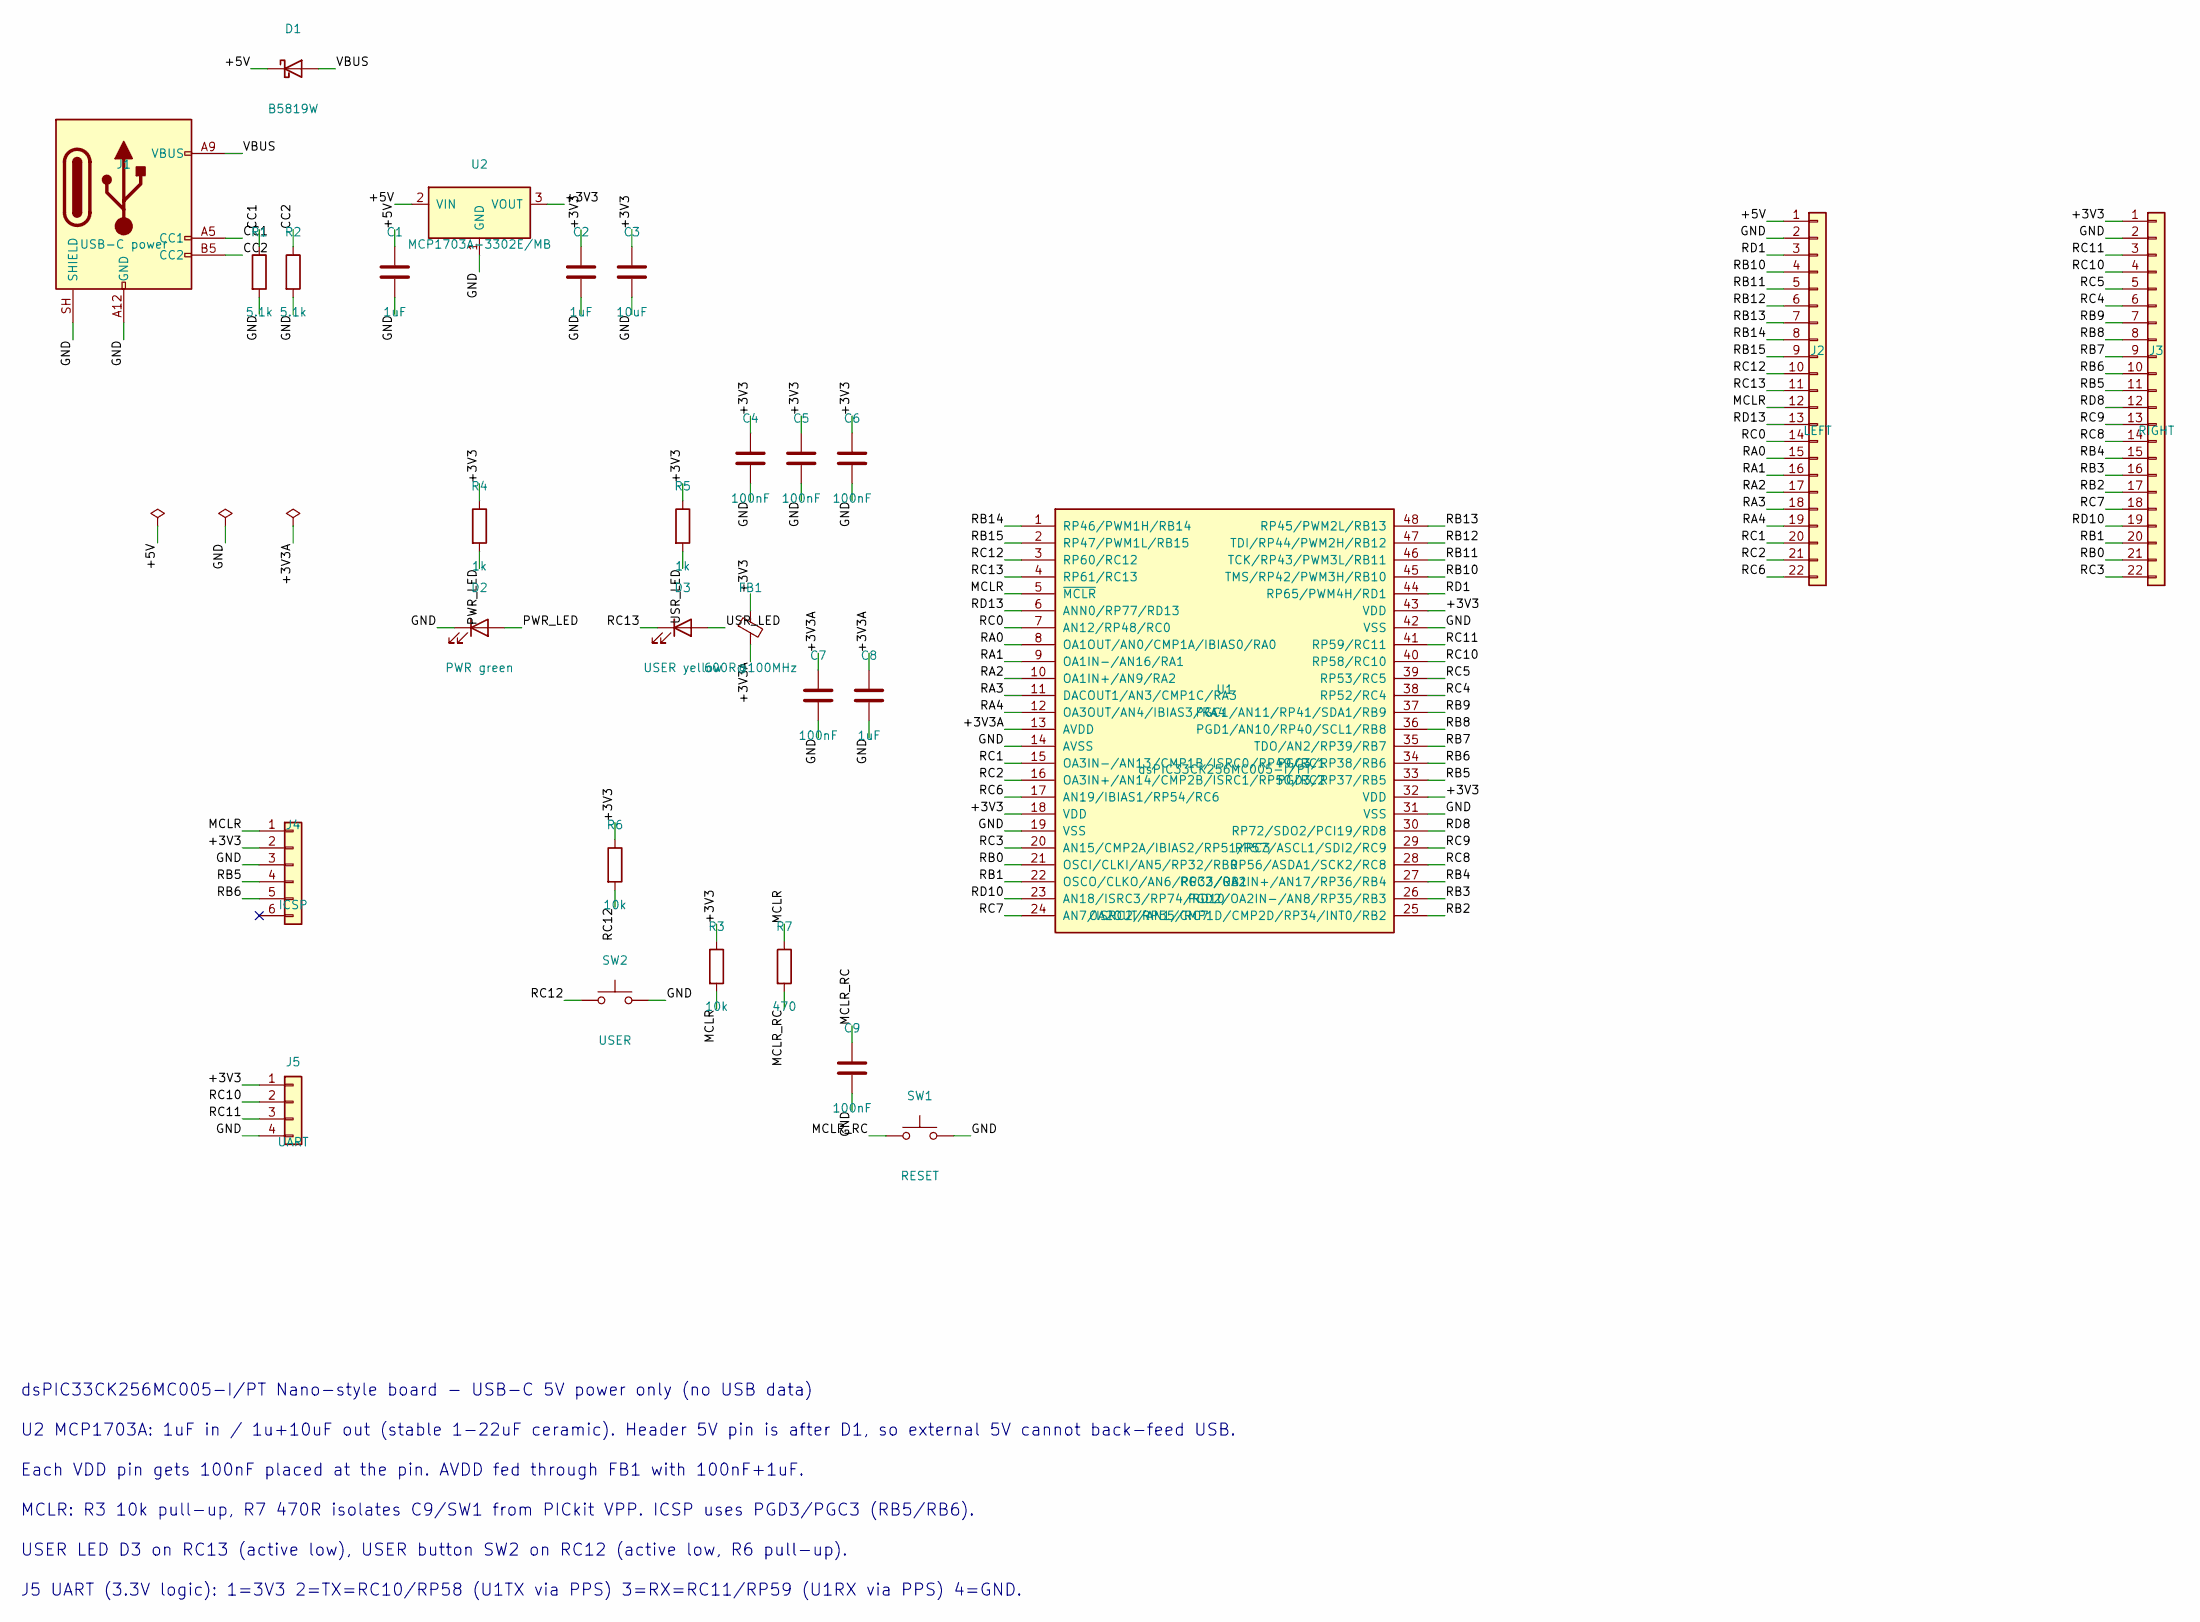
[picture p9: schematic dspic33ck_nano.kicad_sch, dsPIC33CK256MC005 Nano board]

Parts:
C1, C2, C8: 1uF; C_0805_2012Metric; MPN 0805 1uF 16V X7R
C3: 10uF; C_0805_2012Metric; MPN 0805 10uF 10V X5R
C4, C5, C6, C7, C9: 100nF; C_0805_2012Metric; MPN 0805 100nF 16V X7R
D1: B5819W; D_SOD-123; MPN B5819W
D2: PWR green; LED_0603_1608Metric; MPN 0603 green LED
D3: USER yellow; LED_0603_1608Metric; MPN 0603 yellow LED
FB1: 600R@100MHz; L_0603_1608Metric; MPN BLM18AG601SN1D
J1: USB-C power; USB_C_Receptacle_GCT_USB4125-xx-x-0190_6P_TopMnt_Horizontal; MPN GCT USB4125-GF-A
J2: LEFT; PinHeader_1x22_P2.54mm_Vertical; MPN 1x22 2.54mm header
J3: RIGHT; PinHeader_1x22_P2.54mm_Vertical; MPN 1x22 2.54mm header
J4: ICSP; PinHeader_1x06_P2.54mm_Vertical; MPN 1x6 2.54mm header (PICkit)
J5: UART; PinHeader_1x04_P2.54mm_Vertical; MPN 1x4 2.54mm header (UART)
R1, R2: 5.1k; R_0805_2012Metric; MPN 0805 5.1k 1%
R3, R6: 10k; R_0805_2012Metric; MPN 0805 10k 1%
R4, R5: 1k; R_0805_2012Metric; MPN 0805 1k 1%
R7: 470; R_0805_2012Metric; MPN 0805 470R 1%
SW1: RESET; SW_SPST_TL3342; MPN E-Switch TL3342 series (4.2x3.2mm SMD t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
SW2: USER; SW_SPST_TL3342; MPN E-Switch TL3342 series (4.2x3.2mm SMD t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
U1: dsPIC33CK256MC005-I/PT; TQFP-48_7x7mm_P0.5mm; MPN dsPIC33CK256MC005-I/PT
U2: MCP1703A-3302E/MB; SOT-89-3; MPN MCP1703AT-3302E/MB

Connections:
/+3V3: C2.1, C3.1, C4.1, C5.1, C6.1, FB1.1, J3.1, J4.2, J5.1, R3.1, R4.1, R5.1, R6.1, U1.18 (VDD), U1.32 (VDD), U1.43 (VDD), U2.3 (VOUT)
/+3V3A: C7.1, C8.1, FB1.2, U1.13 (AVDD)
/+5V: C1.1, D1.1 (K), J2.1, U2.2 (VIN)
/CC1: J1.A5 (CC1), R1.1
/CC2: J1.B5 (CC2), R2.1
/GND: C1.2, C2.2, C3.2, C4.2, C5.2, C6.2, C7.2, C8.2, C9.2, D2.1 (K), J1.A12 (GND), J1.B12 (GND), J1.SH (SHIELD), J2.2, J3.2, J4.3, J5.4, R1.2, R2.2, SW1.2, SW2.2, U1.14 (AVSS), U1.19 (VSS), U1.31 (VSS), U1.42 (VSS), U2.1 (GND)
/MCLR: J2.12, J4.1, R3.2, R7.1, U1.5 (~MCLR)
/MCLR_RC: C9.1, R7.2, SW1.1
/PWR_LED: D2.2 (A), R4.2
/RA0: J2.15, U1.8 (OA1OUT/AN0/CMP1A/IBIAS0/RA0)
/RA1: J2.16, U1.9 (OA1IN-/AN16/RA1)
/RA2: J2.17, U1.10 (OA1IN+/AN9/RA2)
/RA3: J2.18, U1.11 (DACOUT1/AN3/CMP1C/RA3)
/RA4: J2.19, U1.12 (OA3OUT/AN4/IBIAS3/RA4)
/RB0: J3.21, U1.21 (OSCI/CLKI/AN5/RP32/RB0)
/RB1: J3.20, U1.22 (OSCO/CLKO/AN6/RP33/RB1)
/RB2: J3.17, U1.25 (OA2OUT/AN1/CMP1D/CMP2D/RP34/INT0/RB2)
/RB3: J3.16, U1.26 (PGD2/OA2IN-/AN8/RP35/RB3)
/RB4: J3.15, U1.27 (PGC2/OA2IN+/AN17/RP36/RB4)
/RB5: J3.11, J4.4, U1.33 (PGD3/RP37/RB5)
/RB6: J3.10, J4.5, U1.34 (PGC3/RP38/RB6)
/RB7: J3.9, U1.35 (TDO/AN2/RP39/RB7)
/RB8: J3.8, U1.36 (PGD1/AN10/RP40/SCL1/RB8)
/RB9: J3.7, U1.37 (PGC1/AN11/RP41/SDA1/RB9)
/RB10: J2.4, U1.45 (TMS/RP42/PWM3H/RB10)
/RB11: J2.5, U1.46 (TCK/RP43/PWM3L/RB11)
/RB12: J2.6, U1.47 (TDI/RP44/PWM2H/RB12)
/RB13: J2.7, U1.48 (RP45/PWM2L/RB13)
/RB14: J2.8, U1.1 (RP46/PWM1H/RB14)
/RB15: J2.9, U1.2 (RP47/PWM1L/RB15)
/RC0: J2.14, U1.7 (AN12/RP48/RC0)
/RC1: J2.20, U1.15 (OA3IN-/AN13/CMP1B/ISRC0/RP49/RC1)
/RC2: J2.21, U1.16 (OA3IN+/AN14/CMP2B/ISRC1/RP50/RC2)
/RC3: J3.22, U1.20 (AN15/CMP2A/IBIAS2/RP51/RC3)
/RC4: J3.6, U1.38 (RP52/RC4)
/RC5: J3.5, U1.39 (RP53/RC5)
/RC6: J2.22, U1.17 (AN19/IBIAS1/RP54/RC6)
/RC7: J3.18, U1.24 (AN7/ISRC2/RP55/RC7)
/RC8: J3.14, U1.28 (RP56/ASDA1/SCK2/RC8)
/RC9: J3.13, U1.29 (RP57/ASCL1/SDI2/RC9)
/RC10: J3.4, J5.2, U1.40 (RP58/RC10)
/RC11: J3.3, J5.3, U1.41 (RP59/RC11)
/RC12: J2.10, R6.2, SW2.1, U1.3 (RP60/RC12)
/RC13: D3.1 (K), J2.11, U1.4 (RP61/RC13)
/RD1: J2.3, U1.44 (RP65/PWM4H/RD1)
/RD8: J3.12, U1.30 (RP72/SDO2/PCI19/RD8)
/RD10: J3.19, U1.23 (AN18/ISRC3/RP74/RD10)
/RD13: J2.13, U1.6 (ANN0/RP77/RD13)
/USR_LED: D3.2 (A), R5.2
/VBUS: D1.2 (A), J1.A9 (VBUS), J1.B9 (VBUS)

Notes on the sheet:
dsPIC33CK256MC005-I/PT Nano-style board - USB-C 5V power only (no USB data)
U2 MCP1703A: 1uF in / 1u+10uF out (stable 1-22uF ceramic). Header 5V pin is after D1, so external 5V cannot back-feed USB.
Each VDD pin gets 100nF placed at the pin. AVDD fed through FB1 with 100nF+1uF.
MCLR: R3 10k pull-up, R7 470R isolates C9/SW1 from PICkit VPP. ICSP uses PGD3/PGC3 (RB5/RB6).
USER LED D3 on RC13 (active low), USER button SW2 on RC12 (active low, R6 pull-up).
J5 UART (3.3V logic): 1=3V3 2=TX=RC10/RP58 (U1TX via PPS) 3=RX=RC11/RP59 (U1RX via PPS) 4=GND.

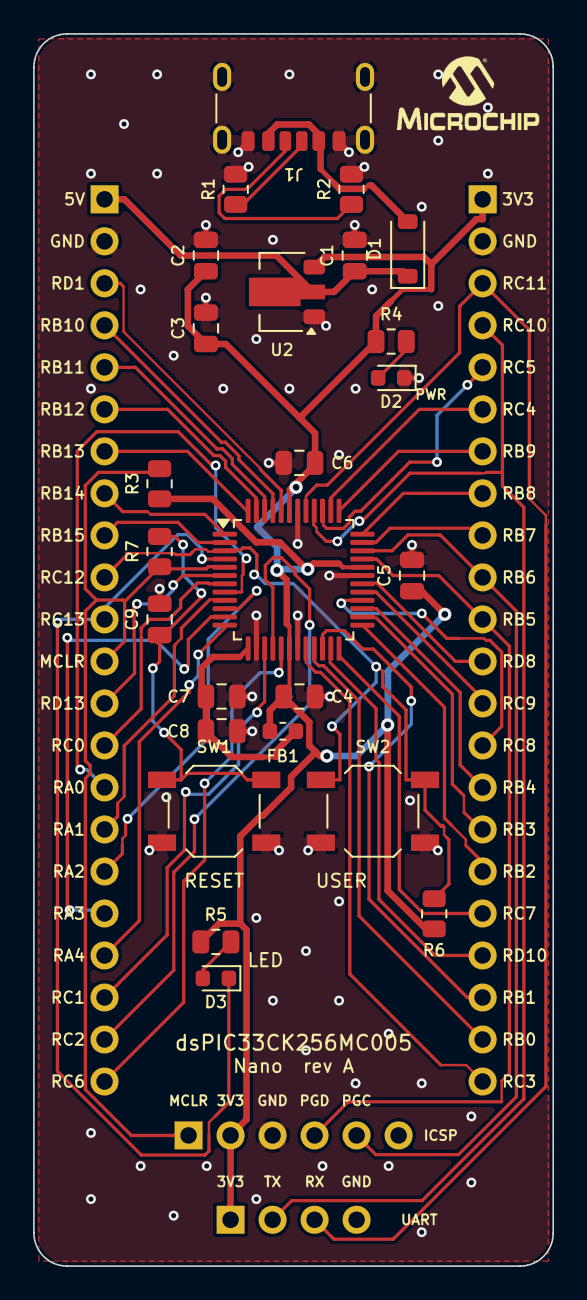
[picture p10: board dspic33ck_nano.kicad_pcb from above]

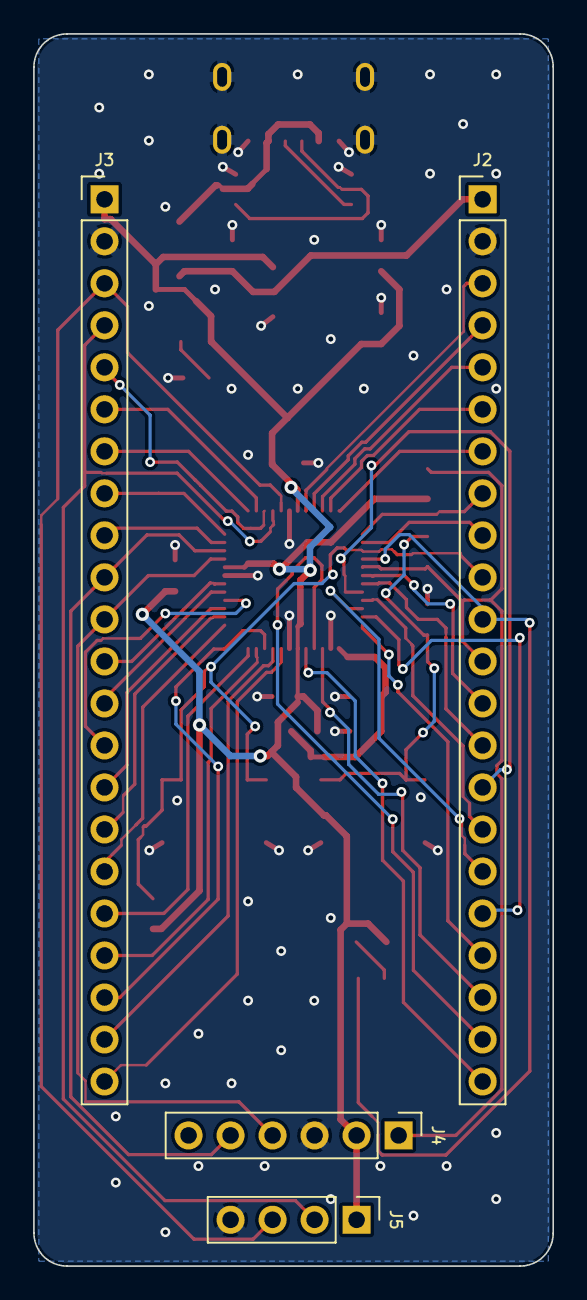
[picture p11: board dspic33ck_nano.kicad_pcb from below]

Board: 2 copper layers, 31.4 x 74.5 mm, 30 parts (4 on the bottom side), 50 nets.

Other parts of the board:
LOGO1: Microchip_Logo
