microchipthailand/dspic33ck-nano/(commit log)

2026-11-12 Initial release: dsPIC33CK Nano board, Arduino core, labs, PCB
    Includes Boards Manager index (package_dspicnano_index.json) and
    arduino/tools/make_release.py to build the platform archive.
    [bom.csv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]
2026-11-14 v1.0.1
    v1.0.1: Labs 28-30, 4-channel DMA lab, Thai manual, C++ constructors, pinout on README
